veresvr/DriverBoardForCNC/(list of files, cad)

Other CAD files:
Dimensions.DWG
DriverBoardForCNC/DriverBoardForCNC - TestPadsCoordinates.DWG
Dimensions.SLDDRW
