veresvr/DriverBoardForCNC/DriverBoardForCNCScheme.pdf

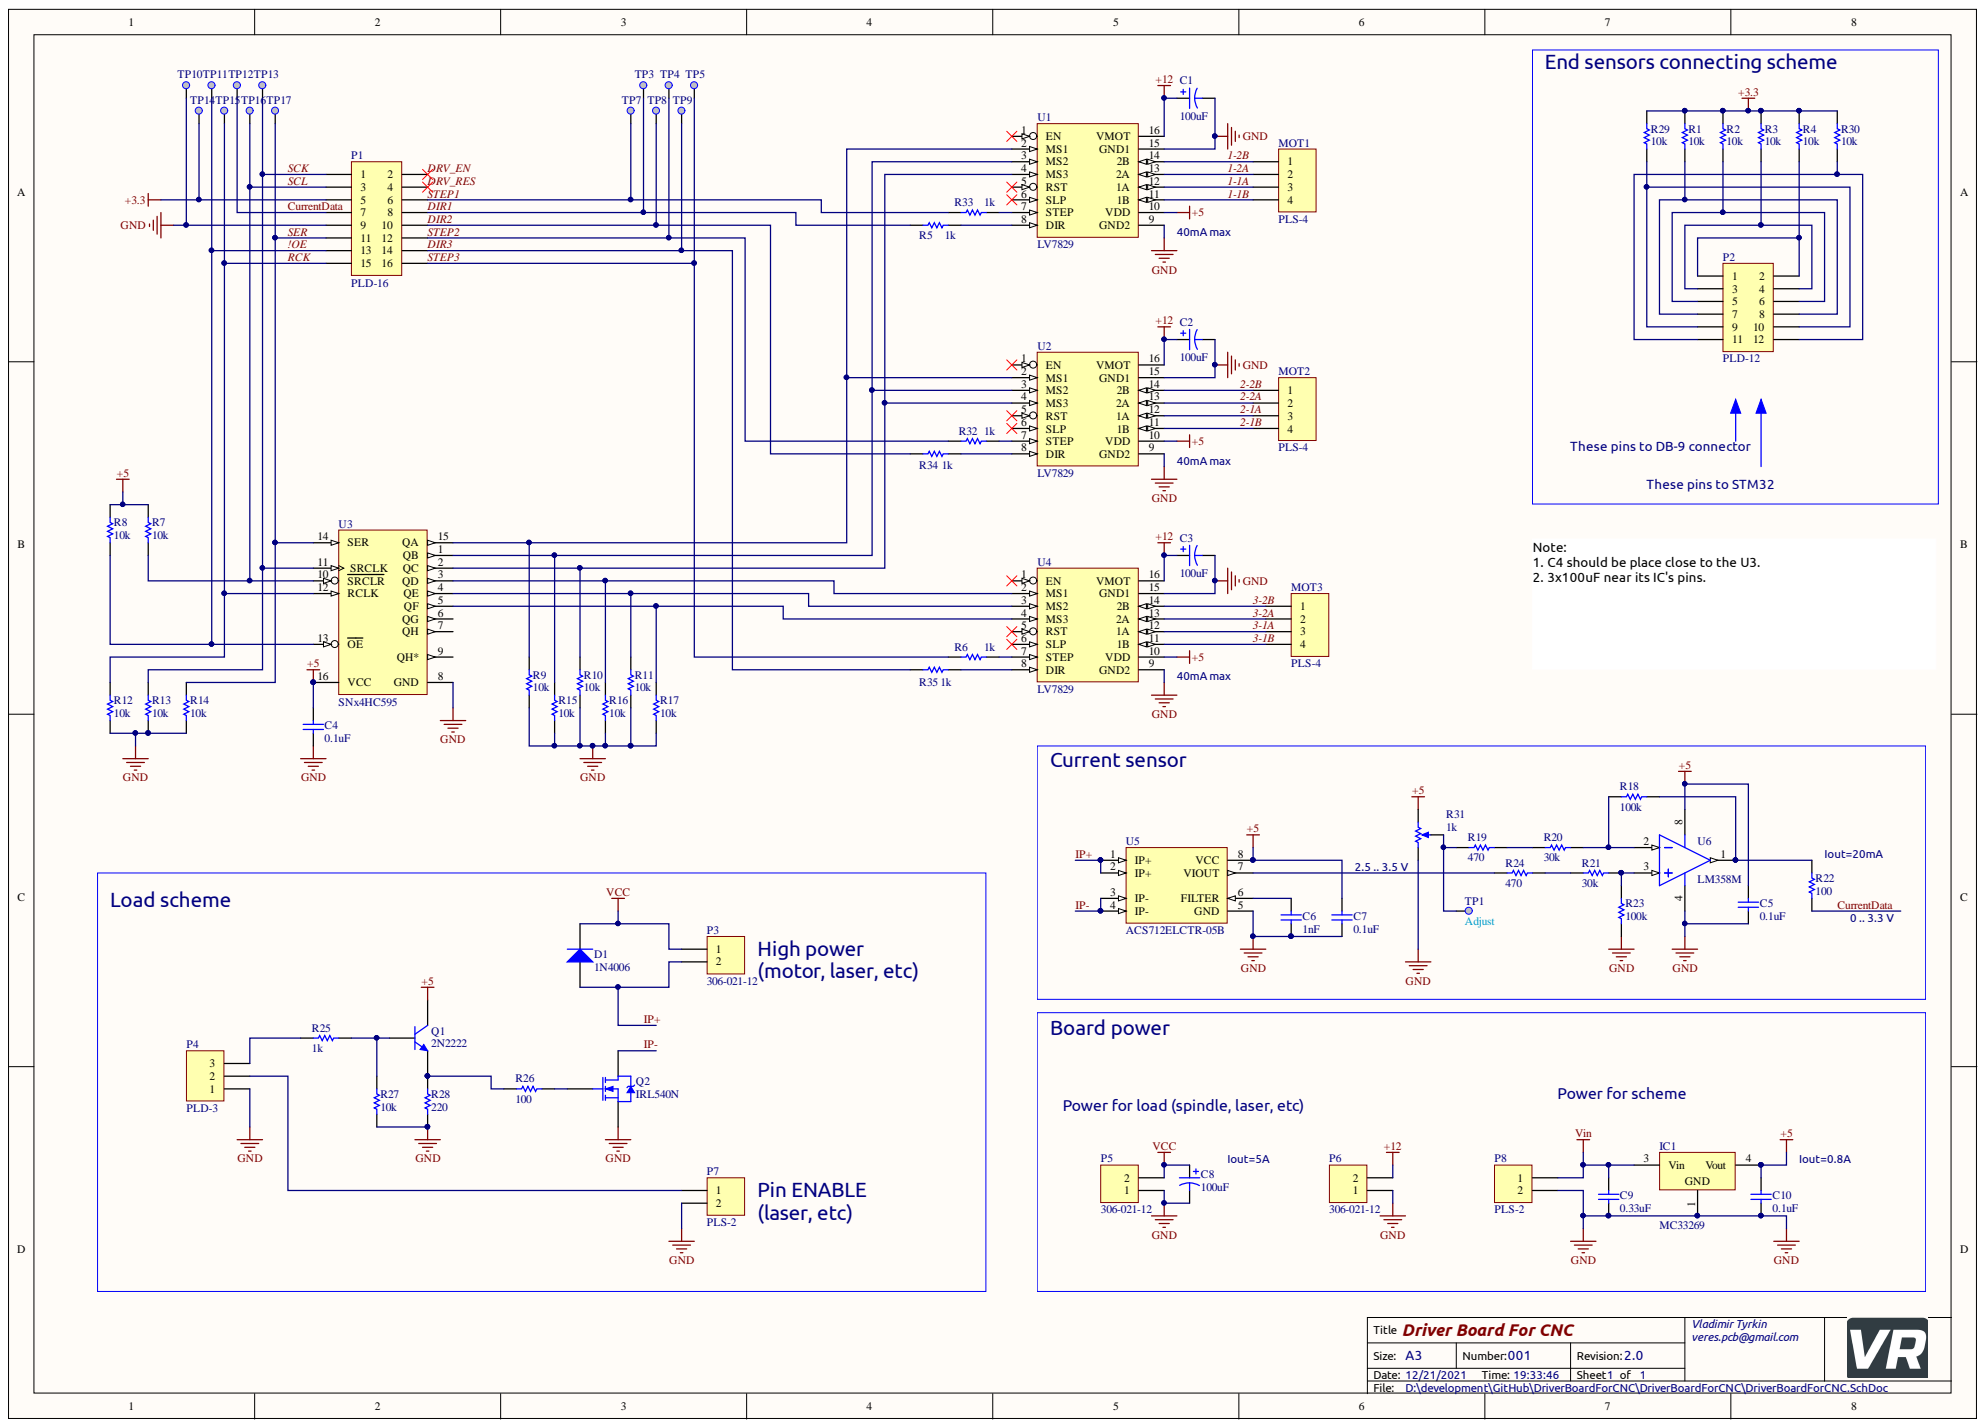
[picture p3: page 1]

End sensors connecting scheme

5 6
7 8 9 10

These pins to DB-9 connector

Note:
1. C4 should be place close to the U3.
2. 3x100uF near its IC's pins.

Driver Board For CNC Title | Vladimir Tyrkin veres.pcb@gmail.com

Size: A3 | Number: 001 | Revision: 2.0
Date: 12/21/2021 Time: 19:33:46 | | Sheet 1 of 1

D:\development\GitHub\DriverBoardForCNC\DriverBoardForCNC\DriverBoardForCNC.SchDoc
File:
