veresvr/DriverBoardForCNC/(list of files, drawings)

Other design files:
DriverBoardForCNC/DriverBoardForCNC.PcbDoc
DriverBoardForCNC/DriverBoardForCNC.PcbLib
DriverBoardForCNC/DriverBoardForCNC.PrjPcb
DriverBoardForCNC/DriverBoardForCNC.SchDoc
DriverBoardForCNC/DriverBoardForCNC.SCHLIB
DriverBoardForCNC/PCB1.PcbDoc
