veresvr/DriverBoardForCNC/(commit log)

2021-02-22 Added pcb contour, some libs
    [CAP 0805.x_b, DO-41-L=10.16.x_b, Dimensions.DWG, DriverBoardForCNC.PcbDoc, DriverBoardForCNC.PrjPcb, DriverBoardForCNC.SchDoc, L6.3 SIZE CODE C55.x_b, LV8729Driver.x_b]
2021-02-28 Updated library, scheme, pcb
    [Dimensions.SLDDRW, DriverBoardForCNC.PcbDoc, DriverBoardForCNC.PrjPcb, DriverBoardForCNC.SCHLIB, DriverBoardForCNC.SchDoc, driverBoard.PcbLib]
2021-02-28 Updated scheme components and its libraries
    [DriverBoardForCNC.PcbDoc, DriverBoardForCNC.SCHLIB, DriverBoardForCNC.SchDoc, jumper1.PCBLIB, jumper1.SCHLIB]
2021-03-03 Updated libraries, scheme
    [DriverBoardForCNC.PrjPcb, DriverBoardForCNC.SCHLIB, DriverBoardForCNC.SchDoc, jumper.PCBLIB, jumper.SCHLIB, jumper1.PCBLIB, jumper1.SCHLIB]
2021-03-04 Updated Jumper library
    [DriverBoardForCNC.PrjPcb, DriverBoardForCNC.SCHLIB, DriverBoardForCNC.SchDoc, PLS (DS1021-2x5).x_t, PLS (DS1021-2x8).x_t, jumper.PCBLIB, jumper.SCHLIB]
2021-03-05 Added mount holes, updated scheme
    [DriverBoardForCNC.SCHLIB, DriverBoardForCNC.SchDoc, jumper.SCHLIB]
2021-03-05 Done with end sensors unit
    [DriverBoardForCNC.SchDoc]
2021-03-22 A little updates in pcb
    [DriverBoardForCNC.SchDoc]
2021-03-22 Get all components in the board, updated some rules
    [DriverBoardForCNC.SchDoc]
2021-03-27 Redraw scheme and pcb
    [CAP 0805.x_b, CAP 1206.x_t, DO-41-L=10.16.x_b, Dimensions.DWG, Dimensions.SLDDRW, DriverBoardForCNC.PrjPcb, DriverBoardForCNC.SCHLIB, DriverBoardForCNC.SchDoc]
2021-03-27 Updated pcb and some connections in scheme
    [Sheet1.SchDoc]
2021-03-28 Updated pcb
    [Sheet1.SchDoc]
2021-03-28 Almost done all signals
    [Sheet1.SchDoc]
2021-03-29 Main part of scheme is routed, except Load unit
    [Sheet1.SchDoc]
2021-04-03 Updated scheme in case of load. Added some parameters to components
    [Sheet1.SchDoc]
2021-04-03 The board is resized and the routing is complete
    [DO-41-L=10.16.x_b, DO-41-L=10.5.x_t, Dimensions.DWG, Dimensions.SLDDRW, PCB1.PcbLib]
2021-04-04 Updated the routing. Added some net labels and connector descriptions
    [DriverBoardForCNC.PrjPcb, Sheet1.SchDoc]
2021-04-05 Added connector descriptions
    [Sheet1.SchDoc]
2021-04-07 Updated template in the scheme. Updated layers and library in the pcb. Removed unnecessary library.
    [DriverBoardForCNC.PrjPcb, PCB1.PcbLib, Sheet1.SchDoc, driverBoard.PcbLib]
2021-04-16 Added current sensor scheme
    [DriverBoardForCNC.SCHLIB, Sheet1.SchDoc]
2021-04-17 Updated the current sensor scheme. Added new 3d bodies and updated the pcb.
    [DriverBoardForCNC.SCHLIB, PCB1.PcbLib, SO-8.x_t, Sheet1.SchDoc, Trimmer 3296.x_t]
2021-04-18 Updated the pcb in case of current sensor
    [Sheet1.SchDoc]
2021-04-18 Updated layers in the pcb
2021-04-23 Updated the tracing. Fixed bug in potentiometer drawing
    [DriverBoardForCNC.SCHLIB, Sheet1.SchDoc]
2021-04-23 The pcb has been rerouted with the current sensor scheme
    [DriverBoardForCNC.PrjPcb, PCB1.PcbLib, Resistor 1206.x_t, Sheet1.SchDoc]
2021-04-23 A little optimization for the pcb
2021-04-24 Updated the overlay drawing in pcb
2021-04-25 Added assembly layers to the pcb, and updated library for that. Added polygons for sensor. Renamed some documents.
    [DriverBoardForCNC.PcbLib, DriverBoardForCNC.PrjPcb, DriverBoardForCNC.SchDoc, PCB1.PcbLib, Sheet1.SchDoc]
2021-04-25 Updated the rules for JLCPCB manufacturer, updated the overlay layer for accorded the rules
    [DriverBoardForCNC.PcbLib, DriverBoardForCNC.PrjPcb]
2021-05-01 Made .outjob file for generating files for production, which are used for generating rendering textures
    [DriverBoardForCNC.GBL, DriverBoardForCNC.GBO, DriverBoardForCNC.GBS, DriverBoardForCNC.GTL, DriverBoardForCNC.GTO, DriverBoardForCNC.GTS]
2021-05-04 Updated parameters of components for BOM list
    [DriverBoardForCNC.PcbLib, DriverBoardForCNC.PrjPcb, DriverBoardForCNC.SCHLIB, DriverBoardForCNC.SchDoc]
2021-05-04 Has redrawn some components and updated parameters
    [DriverBoardForCNC.PrjPcb, DriverBoardForCNC.SCHLIB, DriverBoardForCNC.SchDoc]
2021-05-05 Added Draftsman document and made some drawings
    [DriverBoardForCNC.PrjPcb, DriverBoardForCNC.SchDoc]
2021-05-08 Generated 3D files from Altium and made KeyShot project
    [DriverBoardForCNC.PrjPcb]
2021-05-19 Added Drill table and BOM to the Draftsman document, fixed some issues in libraries
    [DriverBoardForCNC.PcbLib, DriverBoardForCNC.PrjPcb, DriverBoardForCNC.SCHLIB, DriverBoardForCNC.SchDoc]
2021-05-23 Updated BOM document, changed some parameters in components
    [DriverBoardForCNC.SchDoc]
2021-05-26 Updated the circuit in the current sensor unit: changed some values of the resistors
    [DriverBoardForCNC.SchDoc]
2021-06-02 Updated resistors in the current sensor unit
    [DriverBoardForCNC.PrjPcb, DriverBoardForCNC.SchDoc]
2021-06-06 Updated parts properties and packages, refresh the BOM
    [DriverBoardForCNC.PrjPcb, DriverBoardForCNC.SchDoc]
2021-06-17 Updated the scheme in case of end sensors: added 2 more channels (for Z axis). Imported changes to the board, rerouted it. Increased some GND wires.
    [DriverBoardForCNC.PcbLib, DriverBoardForCNC.PrjPcb, DriverBoardForCNC.SCHLIB, DriverBoardForCNC.SchDoc, PLS (DS1021-2x6).x_t]
2021-06-24 Updated the scheme after testing the Op Amp
    [DriverBoardForCNC.SchDoc]
2021-06-24 Added rooms to the pcb. And test points to the scheme
    [DriverBoardForCNC.PrjPcb, DriverBoardForCNC.SCHLIB, DriverBoardForCNC.SchDoc]
2021-06-25 The board has been rerouted with the new op amp scheme
    [DriverBoardForCNC.PcbLib, DriverBoardForCNC.PrjPcb, DriverBoardForCNC.SCHLIB, DriverBoardForCNC.SchDoc]
2021-06-27 Updated the tracks: increased the width. Updated overlay layer. Added JLCPCB rules in the pcb and tested it. Added teardrops
    [DriverBoardForCNC.PcbLib, DriverBoardForCNC.PrjPcb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]
2021-06-30 Finally checked the scheme and the board. Updated all parameters in the parts. Updated the overlay layer.
    [DriverBoardForCNC.PrjPcb, DriverBoardForCNC.SchDoc]
2021-07-03 Rechecked all the project, updated C6 (replaced the package)
    [CAP 0805.x_t, DriverBoardForCNC.PcbLib, DriverBoardForCNC.PrjPcb, DriverBoardForCNC.SCHLIB, DriverBoardForCNC.SchDoc]
2021-07-03 Generated data for production
    [DriverBoardForCNC.PrjPcb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]
2021-07-10 Updated the BOM
2021-07-11 Added a few test points to the scheme (P1 connector). Updated the pcb.
    [DriverBoardForCNC.PcbLib, DriverBoardForCNC.PrjPcb, DriverBoardForCNC.SCHLIB, DriverBoardForCNC.SchDoc]
2021-07-25 Fixed circuit error: in IC1 the contacts were not connected correctly (1st was IN, 3rd was OUT). Added new to-92 footprint to the pcb library.
    [DriverBoardForCNC.PcbLib, DriverBoardForCNC.PrjPcb, DriverBoardForCNC.SCHLIB, DriverBoardForCNC.SchDoc, TO-92_line_pin_2_5mm_pitch.x_t]
2021-07-25 Placed the control points on the 1mm grid, rerouted the board. Updated geometry in the overlay layer in the library
    [DriverBoardForCNC.PcbLib]
2021-07-28 Fixed circuit error: in U3 the power contacts were not designed correctly in library. Updated the library, the scheme and the board
    [DriverBoardForCNC.PrjPcb, DriverBoardForCNC.SCHLIB, DriverBoardForCNC.SchDoc]
2021-07-31 Updated marking of the stepper motors connectors. Updated the scheme connection for pin EN. Updated the driver module in the schematic library.
    [DriverBoardForCNC.PrjPcb, DriverBoardForCNC.SCHLIB, DriverBoardForCNC.SchDoc]
2021-08-01 Updated the scheme connection for pin RST. Updated the driver module in the schematic library.
    [DriverBoardForCNC.SCHLIB, DriverBoardForCNC.SchDoc]
2021-08-12 Added to the library another one voltage regulator. Added to the scheme and the board.
    [DriverBoardForCNC.PcbLib, DriverBoardForCNC.PrjPcb, DriverBoardForCNC.SCHLIB, DriverBoardForCNC.SchDoc]
2021-08-21 Updated connections to stepper motor drivers.
    [DriverBoardForCNC.SchDoc]
2021-08-23 Updated the board: rerouted almost all new nets and components
    [DriverBoardForCNC.SchDoc]
2021-08-25 Updated marking in library for 1st pin in SO-8 for better identification.
    [DriverBoardForCNC.PcbLib, DriverBoardForCNC.SchDoc]
2021-09-01 Applied the new voltage regulator to the scheme. Rerouted the board. Updated marking on the overlay layer
    [DriverBoardForCNC.SchDoc]
2021-10-06 Added markers to the library for the test pads. Generated the .dwg file with hole coordinates
    [DriverBoardForCNC - TestPadsCoordinates.DWG, DriverBoardForCNC.PcbLib]
2021-12-21 Updated the board to correspond manufacturer requirements.
2021-12-21 Removed some 3d packages again
    [CAP 0805.x_t, CAP 1206.x_t, DO-41-L=10.5.x_t, L6.3 SIZE CODE C55.x_b, LV8729Driver.x_b, PLS (DS1021-2x3).x_b, PLS (DS1021-2x4).x_b, PLS (DS1021-2x5).x_t]
2021-12-21 Added BOM and the scheme drawing.
    [DriverBoardForCNC.SchDoc]
2021-12-22 Added draftsman documents for the board.
    [DriverBoardForCNC.PrjPcb]
2021-12-22 Updated the board for rendering.
